RadimRiha/HDR_line_camera/PCB/HDR camera controller/V1.0/Schematics/controller connectors.pdf

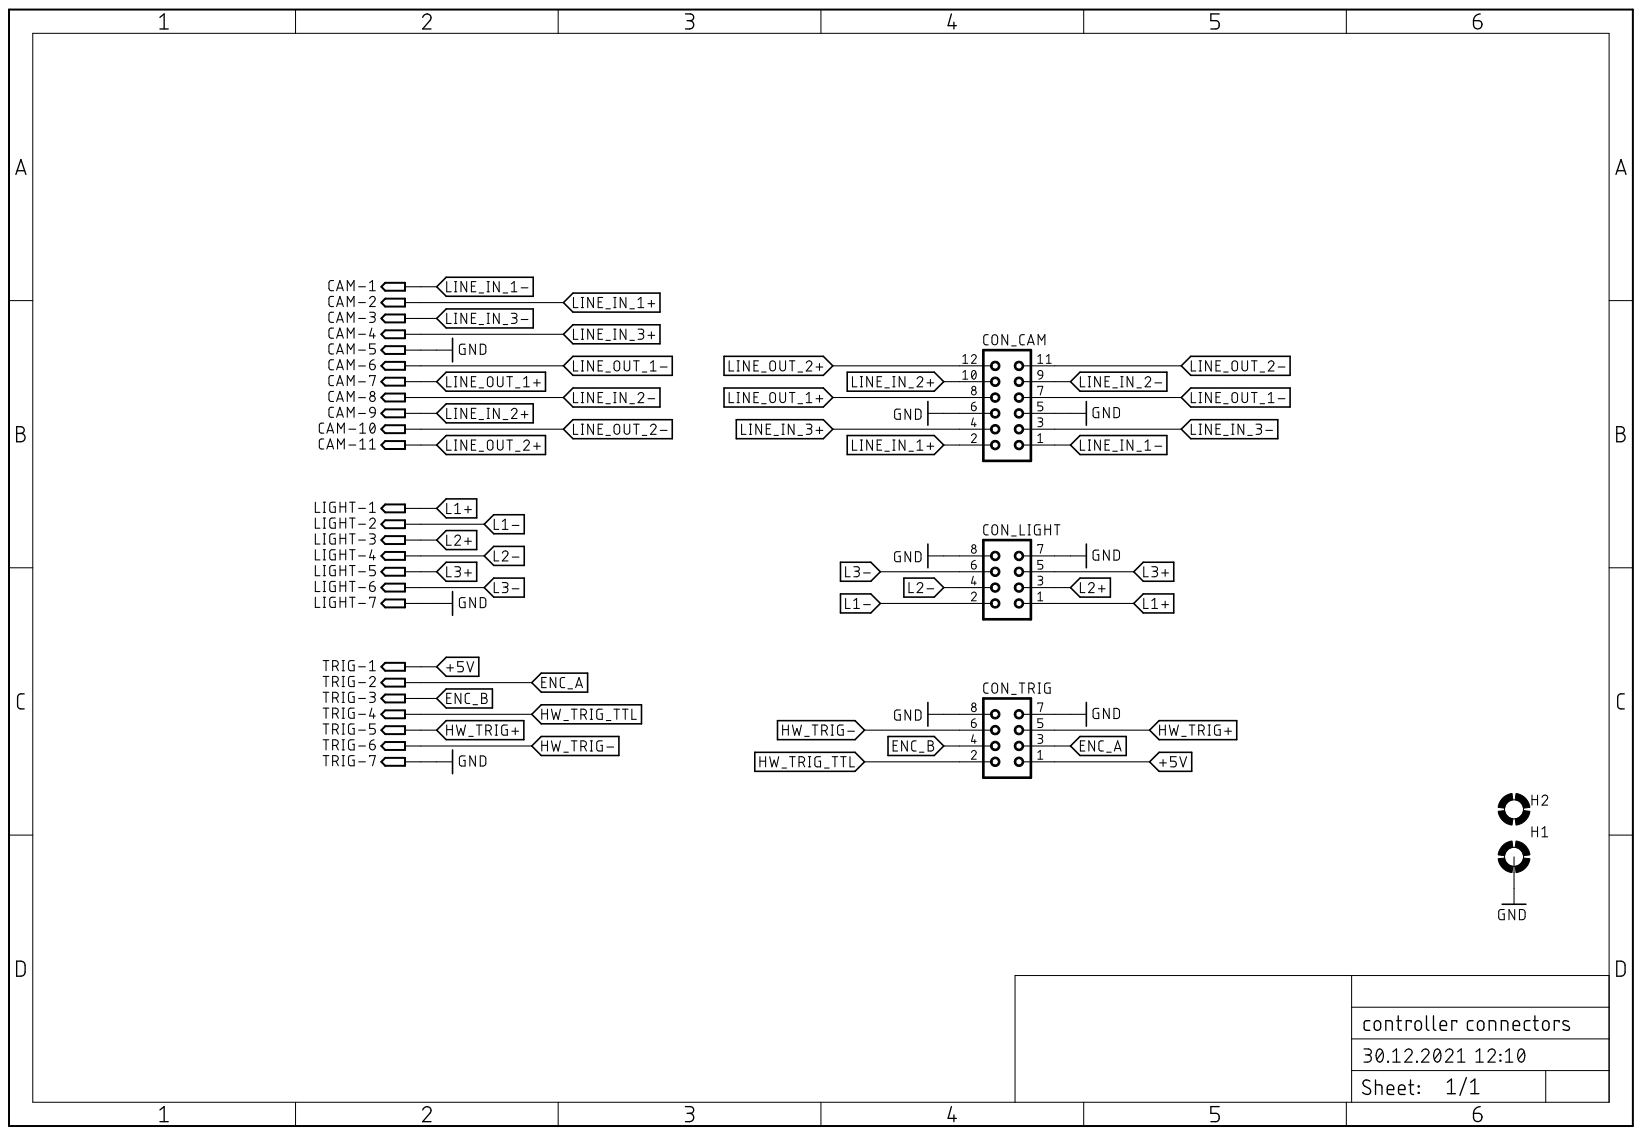
[picture p1: page 1]
