RadimRiha/HDR_line_camera/PCB/HDR camera controller/V1.0/Schematics/HDR camera controller.pdf

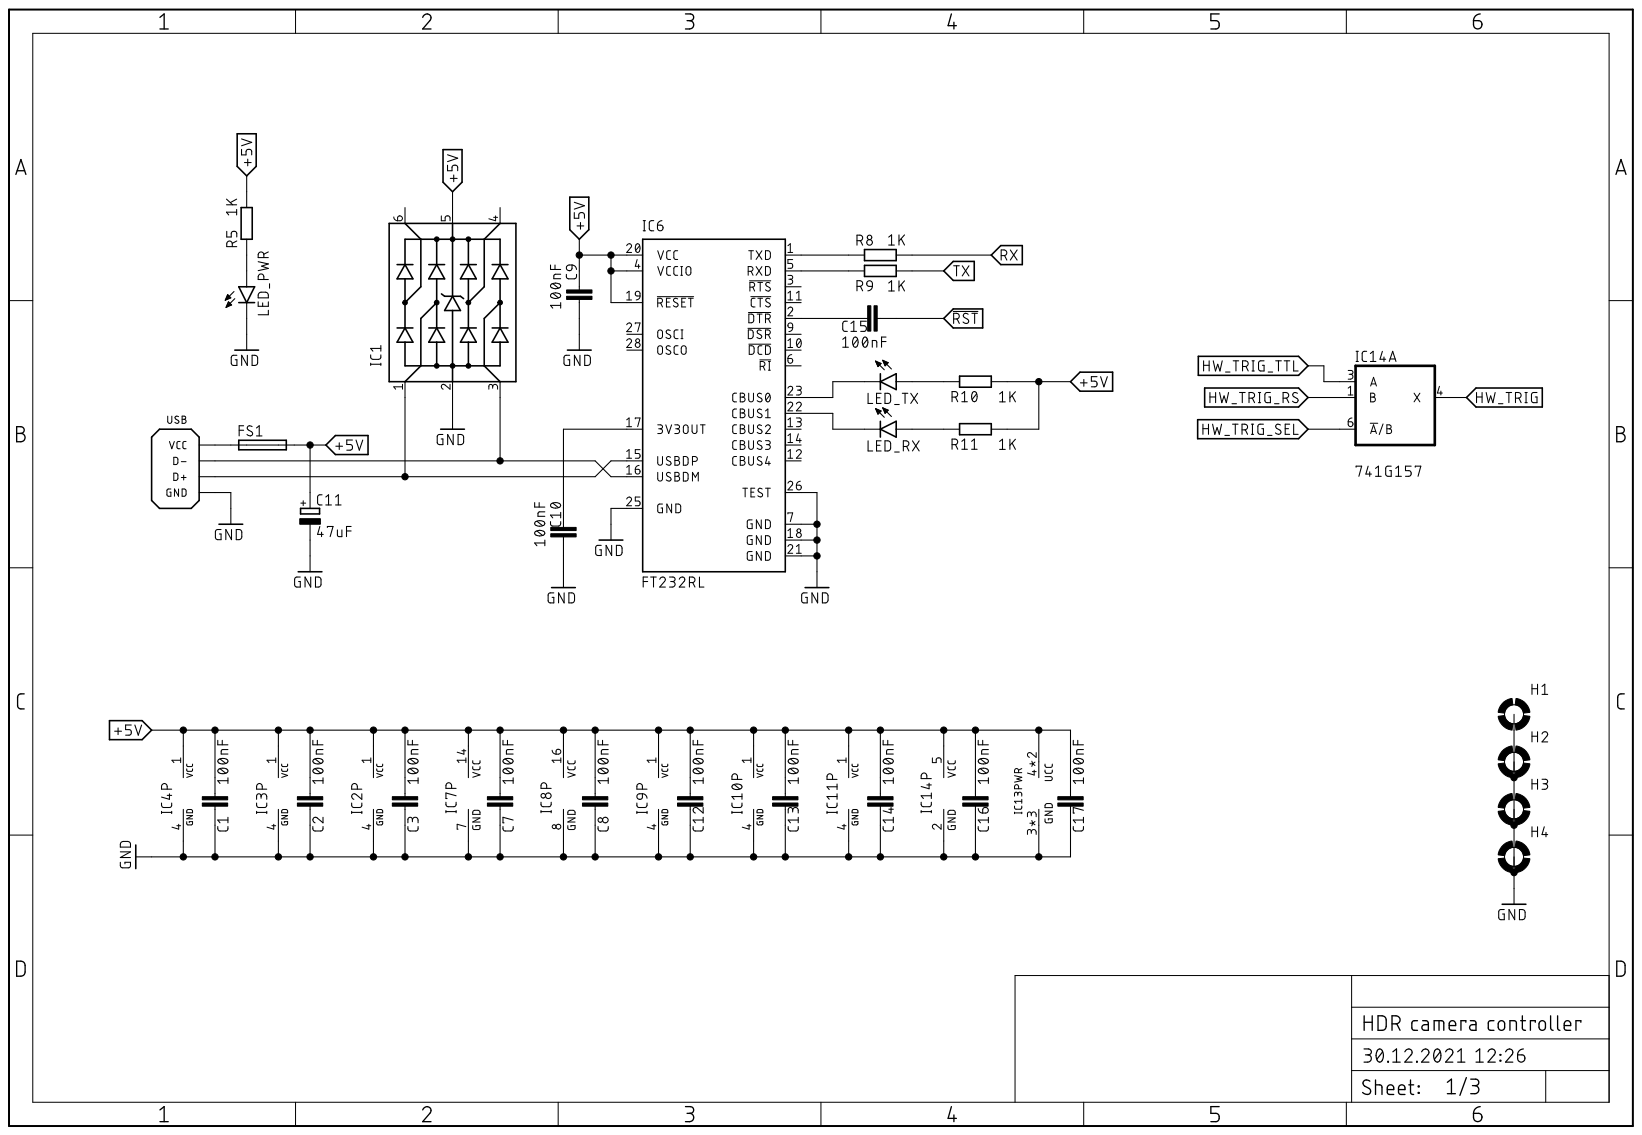
[picture p2: page 1]

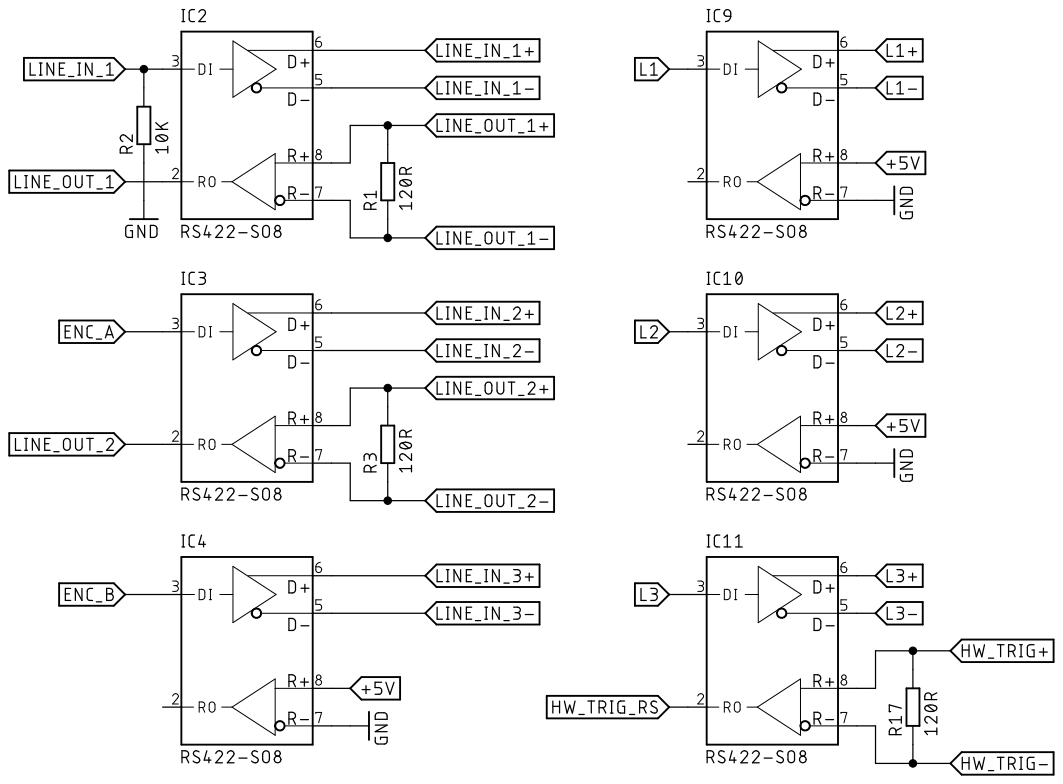
[picture p3: page 2]

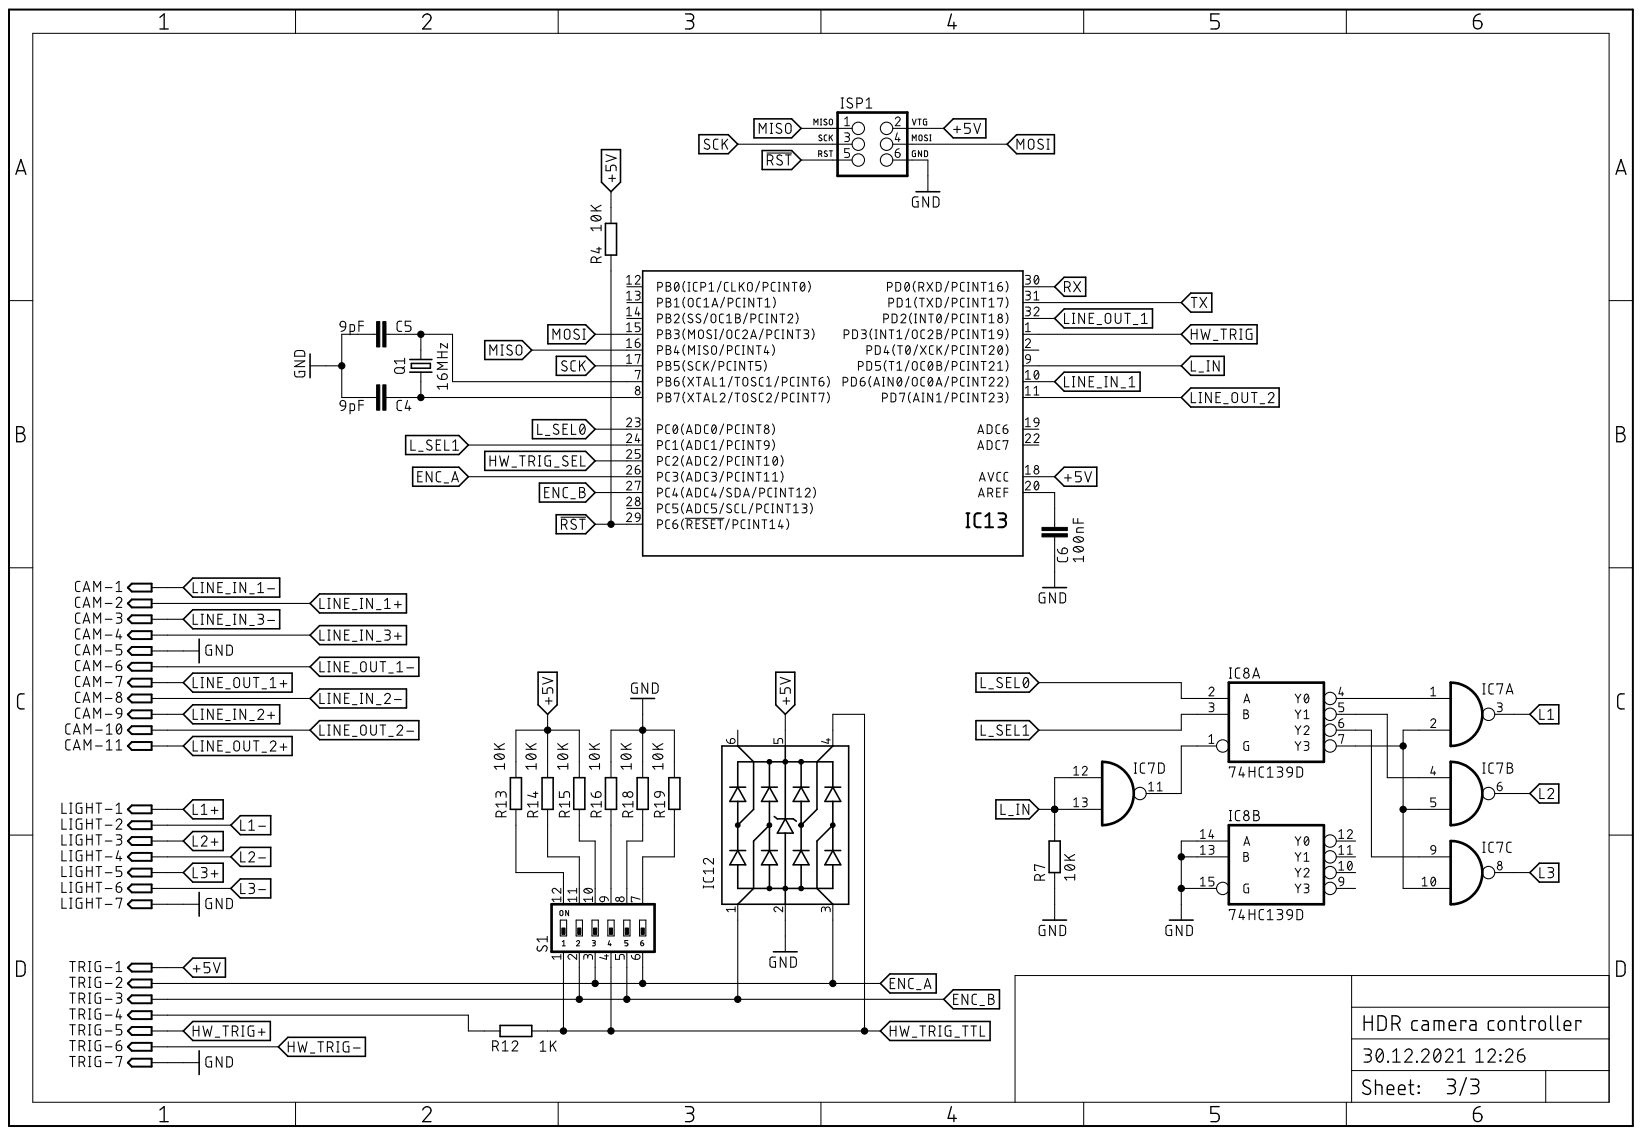
[picture p4: page 3]
