RadimRiha/HDR_line_camera/PCB/HDR camera controller/V1.1/HDR camera controller.brd

## EAGLE design PCB/HDR camera controller/V1.1/HDR camera controller.brd (2024-04-04)

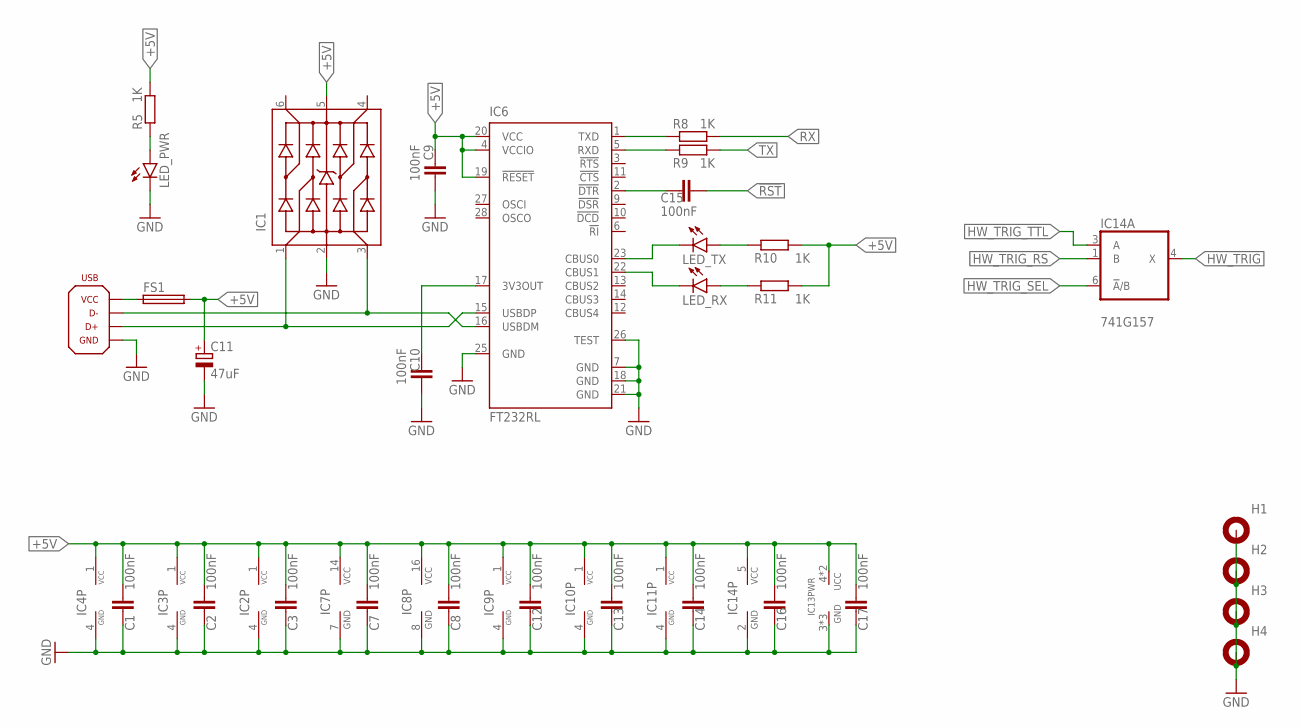
[picture p5: schematic HDR camera controller.sch, sheet 1]

Parts:
C1, C2, C3, C7, C8, C9, C10, C12, C13, C14, C15, C16, C17: 100nF; C0805
C11: 47uF; 153CLV-0605; MPN SC1E476M6L005VR
FS1: POLYFUSE_1210; 1210; MPN SM010-60
H1, H2, H3, H4: HOLE-3MM_PLATED; 3MM_PLATED
IC1: USBLC6-4; SOT23-6; MPN USBLC6
IC2, IC3, IC4, IC9, IC10, IC11: RS422-SO8; SO08; MPN DS8921AMX/NOPB
IC6: FT232RL; SSOP28
IC7: 74HC00D; SO14; MPN SN74HC00DR
IC8: 74HC139D; SO16; MPN SN74HC139DR
IC13: ATMEGA48/88/168/328-AU; TQFP32-08
IC14: 741G157; SOT457W_PHILIPS; MPN 74LVC1G157GV.125
LED_PWR: LEDSML0805; SML0805
LED_RX: LEDSML0805; SML0805
LED_TX: LEDSML0805; SML0805
R5, R8, R9, R10, R11: 1K; R0805
USB: USB_AB-B_SMD; USB_B_SMD; MPN USBB-G-SMD

Connections:
!RST: C15.1; also elsewhere on the board
+5V: C1.1, C2.1, C3.1, C7.1, C8.1, C9.2, C11.+, C12.1, C13.1, C14.1, C16.1, C17.1, FS1.2, IC1.5, IC2.1 (VCC), IC3.1 (VCC), IC4.1 (VCC), IC6.4 (VCCIO), IC6.19 (!RESET), IC6.20 (VCC), IC7.14 (VCC), IC8.16 (VCC), IC9.1 (VCC), IC10.1 (VCC), IC11.1 (VCC), IC13.4 (UCC), IC13.6 (UCC), IC14.5 (VCC), R5.2, R10.2, R11.2; also elsewhere on the board
GND: C1.2, C2.2, C3.2, C7.2, C8.2, C9.1, C10.1, C11.-, C12.2, C13.2, C14.2, C16.2, C17.2, H1.1, H2.1, H3.1, H4.1, IC1.2, IC2.4 (GND), IC3.4 (GND), IC4.4 (GND), IC6.7 (GND), IC6.18 (GND), IC6.21 (GND), IC6.25 (GND), IC6.26 (TEST), IC7.7 (GND), IC8.8 (GND), IC9.4 (GND), IC10.4 (GND), IC11.4 (GND), IC13.3 (GND), IC13.5 (GND), IC13.21 (GND), IC14.2 (GND), LED_PWR.C, USB.4 (GND), USB.G1 (GND), USB.G2 (GND); also elsewhere on the board
HW_TRIG: IC14.4 (X); also elsewhere on the board
HW_TRIG_RS: IC14.1 (B); also elsewhere on the board
HW_TRIG_SEL: IC14.6 (!A!/B); also elsewhere on the board
HW_TRIG_TTL: IC14.3 (A); also elsewhere on the board
unnamed: IC1.1, IC6.15 (USBDP), USB.3 (D+)
unnamed: IC1.3, IC6.16 (USBDM), USB.2 (D-)
unnamed: FS1.1, USB.1 (VCC)
unnamed: C10.2, IC6.17 (3V3OUT)
unnamed: IC6.1 (TXD), R8.1
unnamed: IC6.5 (RXD), R9.1
unnamed: C15.2, IC6.2 (!DTR)
unnamed: IC6.22 (CBUS1), LED_RX.C
unnamed: IC6.23 (CBUS0), LED_TX.C
unnamed: LED_TX.A, R10.1
unnamed: LED_RX.A, R11.1
unnamed: LED_PWR.A, R5.1
RX: R8.2; also elsewhere on the board
TX: R9.2; also elsewhere on the board

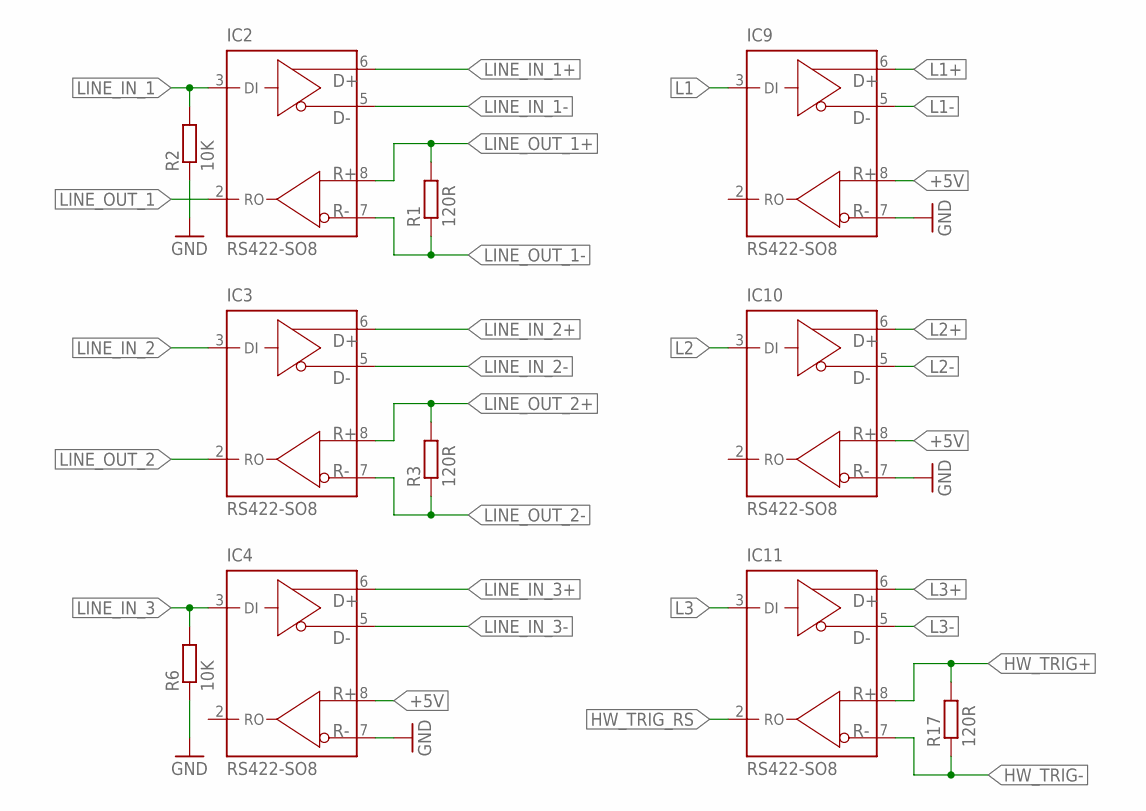
[picture p6: schematic HDR camera controller.sch, sheet 2]

Parts:
IC2, IC3, IC4, IC9, IC10, IC11: RS422-SO8; SO08; MPN DS8921AMX/NOPB
R1, R3, R17: 120R; R0805
R2, R6: 10K; R0805

Connections:
+5V: IC4.8 (R+), IC9.8 (R+), IC10.8 (R+); also elsewhere on the board
GND: IC4.7 (R-), IC9.7 (R-), IC10.7 (R-), R2.1, R6.1; also elsewhere on the board
HW_TRIG+: IC11.8 (R+), R17.2; also elsewhere on the board
HW_TRIG-: IC11.7 (R-), R17.1; also elsewhere on the board
HW_TRIG_RS: IC11.2 (RO); also elsewhere on the board
L1: IC9.3 (DI); also elsewhere on the board
L1+: IC9.6 (D+); also elsewhere on the board
L1-: IC9.5 (D-); also elsewhere on the board
L2: IC10.3 (DI); also elsewhere on the board
L2+: IC10.6 (D+); also elsewhere on the board
L2-: IC10.5 (D-); also elsewhere on the board
L3: IC11.3 (DI); also elsewhere on the board
L3+: IC11.6 (D+); also elsewhere on the board
L3-: IC11.5 (D-); also elsewhere on the board
LINE_IN_1: IC2.3 (DI), R2.2; also elsewhere on the board
LINE_IN_1+: IC2.6 (D+); also elsewhere on the board
LINE_IN_1-: IC2.5 (D-); also elsewhere on the board
LINE_IN_2: IC3.3 (DI); also elsewhere on the board
LINE_IN_2+: IC3.6 (D+); also elsewhere on the board
LINE_IN_2-: IC3.5 (D-); also elsewhere on the board
LINE_IN_3: IC4.3 (DI), R6.2
LINE_IN_3+: IC4.6 (D+); also elsewhere on the board
LINE_IN_3-: IC4.5 (D-); also elsewhere on the board
LINE_OUT_1: IC2.2 (RO); also elsewhere on the board
LINE_OUT_1+: IC2.8 (R+), R1.2; also elsewhere on the board
LINE_OUT_1-: IC2.7 (R-), R1.1; also elsewhere on the board
LINE_OUT_2: IC3.2 (RO); also elsewhere on the board
LINE_OUT_2+: IC3.8 (R+), R3.2; also elsewhere on the board
LINE_OUT_2-: IC3.7 (R-), R3.1; also elsewhere on the board

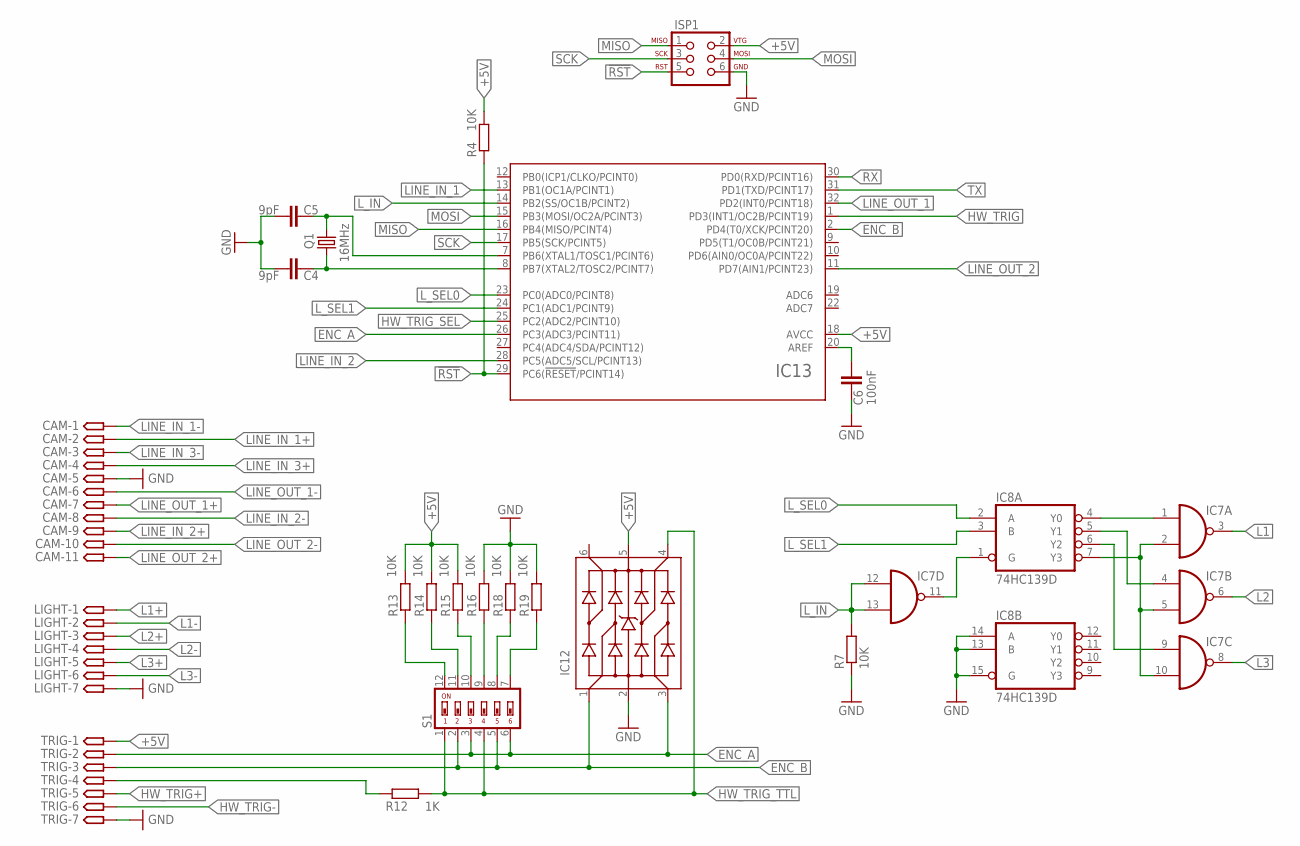
[picture p7: schematic HDR camera controller.sch, sheet 3]

Parts:
C4, C5: 9pF; C0805
C6: 100nF; C0805
CAM: SMPAD-11; S-11P
IC7: 74HC00D; SO14; MPN SN74HC00DR
IC8: 74HC139D; SO16; MPN SN74HC139DR
IC12: USBLC6-4; SOT23-6; MPN USBLC6
IC13: ATMEGA48/88/168/328-AU; TQFP32-08
ISP1: ISP-SMD; ISP_SMD
LIGHT: SMPAD-7; S-7P
Q1: 16MHz; CRYSTAL-3.2X2.5; MPN 3225-16M-SR
R4, R7, R13, R14, R15, R16, R18, R19: 10K; R0805
R12: 1K; R0805
S1: SWS006; SMS-006; MPN A6S-6102-H
TRIG: SMPAD-7; S-7P

Connections:
!RST: IC13.29 (PC6(!RESET!/PCINT14)), ISP1.5 (RST), R4.1; also elsewhere on the board
+5V: IC12.5, IC13.18 (AVCC), ISP1.2 (VTG), R4.2, R13.2, R14.2, R15.2, TRIG.1; also elsewhere on the board
ENC_A: IC12.3, IC13.26 (PC3(ADC3/PCINT11)), S1.3, S1.6, TRIG.2
ENC_B: IC12.1, IC13.2 (PD4(T0/XCK/PCINT20)), S1.2, S1.5, TRIG.3
GND: C4.1, C5.1, C6.2, CAM.5, IC8.13 (B), IC8.14 (A), IC8.15 (G), IC12.2, ISP1.6 (GND), LIGHT.7, R7.1, R16.2, R18.2, R19.2, TRIG.7; also elsewhere on the board
HW_TRIG: IC13.1 (PD3(INT1/OC2B/PCINT19)); also elsewhere on the board
HW_TRIG+: TRIG.5; also elsewhere on the board
HW_TRIG-: TRIG.6; also elsewhere on the board
HW_TRIG_SEL: IC13.25 (PC2(ADC2/PCINT10)); also elsewhere on the board
HW_TRIG_TTL: IC12.4, R12.2, S1.1, S1.4; also elsewhere on the board
L1: IC7.3 (O); also elsewhere on the board
L1+: LIGHT.1; also elsewhere on the board
L1-: LIGHT.2; also elsewhere on the board
L2: IC7.6 (O); also elsewhere on the board
L2+: LIGHT.3; also elsewhere on the board
L2-: LIGHT.4; also elsewhere on the board
L3: IC7.8 (O); also elsewhere on the board
L3+: LIGHT.5; also elsewhere on the board
L3-: LIGHT.6; also elsewhere on the board
LINE_IN_1: IC13.13 (PB1(OC1A/PCINT1)); also elsewhere on the board
LINE_IN_1+: CAM.2; also elsewhere on the board
LINE_IN_1-: CAM.1; also elsewhere on the board
LINE_IN_2: IC13.28 (PC5(ADC5/SCL/PCINT13)); also elsewhere on the board
LINE_IN_2+: CAM.9; also elsewhere on the board
LINE_IN_2-: CAM.8; also elsewhere on the board
LINE_IN_3+: CAM.4; also elsewhere on the board
LINE_IN_3-: CAM.3; also elsewhere on the board
LINE_OUT_1: IC13.32 (PD2(INT0/PCINT18)); also elsewhere on the board
LINE_OUT_1+: CAM.7; also elsewhere on the board
LINE_OUT_1-: CAM.6; also elsewhere on the board
LINE_OUT_2: IC13.11 (PD7(AIN1/PCINT23)); also elsewhere on the board
LINE_OUT_2+: CAM.11; also elsewhere on the board
LINE_OUT_2-: CAM.10; also elsewhere on the board
L_IN: IC7.12 (I0), IC7.13 (I1), IC13.14 (PB2(SS/OC1B/PCINT2)), R7.2
L_SEL0: IC8.2 (A), IC13.23 (PC0(ADC0/PCINT8))
L_SEL1: IC8.3 (B), IC13.24 (PC1(ADC1/PCINT9))
MISO: IC13.16 (PB4(MISO/PCINT4)), ISP1.1 (MISO)
MOSI: IC13.15 (PB3(MOSI/OC2A/PCINT3)), ISP1.4 (MOSI)
unnamed: C5.2, IC13.7 (PB6(XTAL1/TOSC1/PCINT6)), Q1.3 (2)
unnamed: C4.2, IC13.8 (PB7(XTAL2/TOSC2/PCINT7)), Q1.1
unnamed: IC7.11 (O), IC8.1 (G)
unnamed: IC7.1 (I0), IC8.4 (Y0)
unnamed: IC7.4 (I0), IC8.5 (Y1)
unnamed: IC7.9 (I0), IC8.6 (Y2)
unnamed: IC7.2 (I1), IC7.5 (I1), IC7.10 (I1), IC8.7 (Y3)
unnamed: R12.1, TRIG.4
unnamed: R16.1, S1.9
unnamed: R18.1, S1.8
unnamed: R19.1, S1.7
unnamed: R15.1, S1.10
unnamed: R14.1, S1.11
unnamed: R13.1, S1.12
unnamed: C6.1, IC13.20 (AREF)
RX: IC13.30 (PD0(RXD/PCINT16)); also elsewhere on the board
SCK: IC13.17 (PB5(SCK/PCINT5)), ISP1.3 (SCK)
TX: IC13.31 (PD1(TXD/PCINT17)); also elsewhere on the board

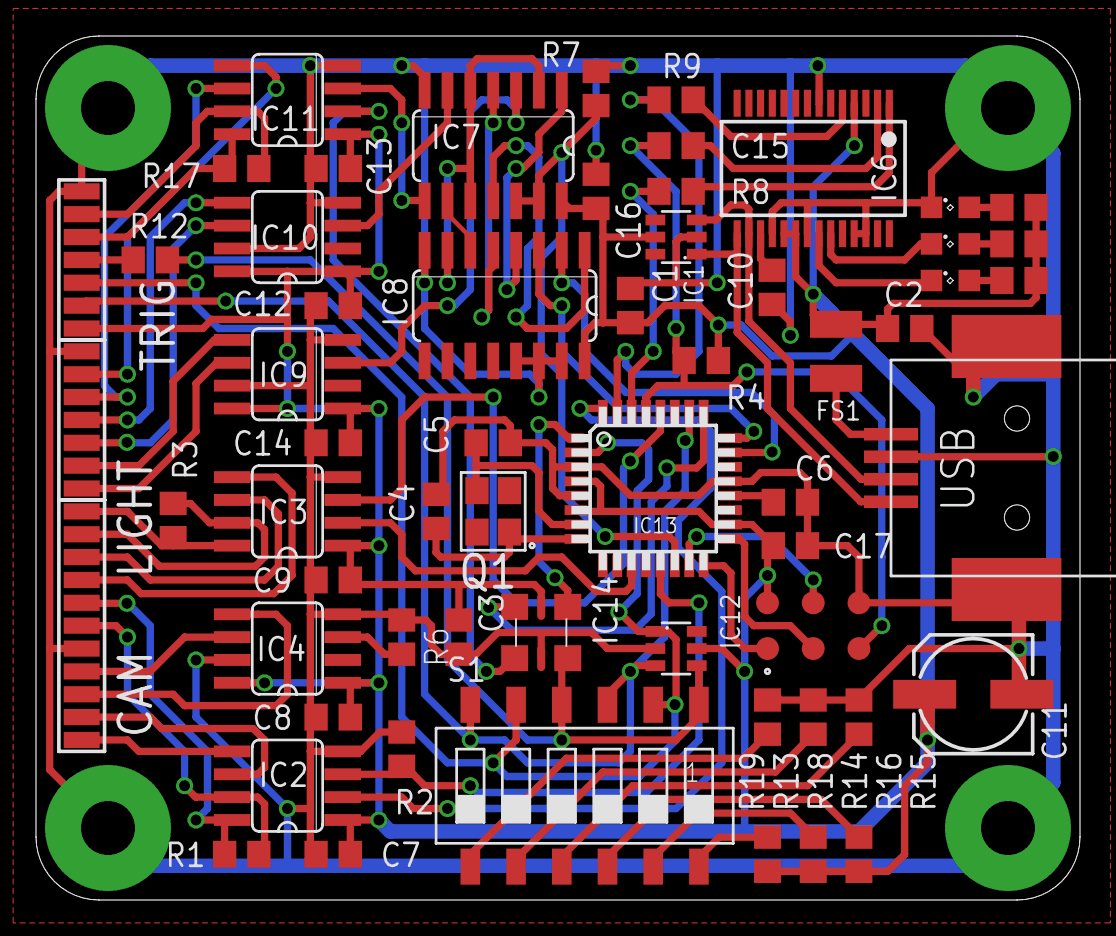
[picture p8: board HDR camera controller.brd from above]

Board: 2 copper layers, 58.0 x 48.0 mm, 64 parts (0 on the bottom side), 70 nets.
