RadimRiha/HDR_line_camera/SW/trigger_controller/trigger_controller/Encoder.h

#ifndef ENCODER_H_
#define ENCODER_H_

#include <stdint.h>

typedef enum encoderChange {
	A_RISING,
	A_FALLING,
	B_RISING,
	B_FALLING
} encoderChange;

extern volatile uint32_t encoderBackcount;
extern volatile uint32_t encoderErrorcount;
// call with one of the encoderChange events to handle the encoder state machine
void encoderStateMachine(uint8_t change);

#endif
