RadimRiha/HDR_line_camera/(commit log)

2021-09-24 PCB init
    [HDR camera controller.sch]
2021-10-01 schematic update
    +USB
    +MCU
    [HDR camera controller.sch]
2021-10-23 trigger controller SW start
    [HDR camera controller.sch]
2021-10-24 Camera trigger wait interrupt
2021-10-24 trigger jitter fix
2021-10-28 finished schematic
    [HDR camera controller.sch]
2021-10-28 PCB WIP
    [HDR camera controller.brd, HDR camera controller.sch]
2021-10-30 PCB V1 manufacture
    [BOM.csv, HDR camera controller.brd, HDR camera controller.sch]
2021-11-06 Timed trigger WIP
    [HDR camera controller.brd, HDR camera controller.sch]
2021-12-04 connector board
    [HDR camera controller.brd, controller connectors.brd, controller connectors.sch]
2021-12-21 amogus did not print, got rid of it :(
    [HDR camera controller.brd, HDR camera controller.sch]
2021-12-30 EEPROM implemented and tested, PCB docs
    [BOM.csv, HDR camera controller.sch, controller connectors.sch]
2022-02-23 camera app switched to winforms
2022-02-28 switched to C#
2022-03-10 Non working camera disconnect event
2022-03-14 Frame width setting handling improved
2022-03-23 Hdr processing WIP
    [responseFunction.csv]
2022-03-24 Hdr processing basic implementation
    [responseFunction.csv]
2024-02-17 Timer1 changed to Timer3
2024-02-18 Pulse timer moved from TC0 to TC1
    [HDR camera controller.brd, HDR camera controller.sch, controller connectors.brd, controller connectors.sch]
2024-02-23 Encoder with back counting implementation
2024-03-02 Line in 2 activation during 1st exposure
    [HDR camera controller.brd, HDR camera controller.sch]
